magnus-berg/waxstation/src/waxstation.py

"""
WAXstation - control software for a chain waxing machine
Copyright (C) 2021  Magnus Berg 

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
from machine import Pin
from settings import Settings
from display import Display
import time
from time import sleep_ms as sleep
import time
from thermometer import Thermometer
from views import OffView, FixedTempView, AutoView
from settingsview import SettingsView

# WaxStation has 4 states
# 0 - Off
# 1 - Low temp
# 2 - High temp
# 3 - Auto temp
# 4 - Settings
class WaxStation:
    def __init__(self, pins, thermometer):
        self.settings = Settings()
        self.settings.load()
        self.waxtimer = None
        self.state = -1
        self.pins = pins
        self.offPin = pins['offPin']
        self.loPin = pins['loPin']
        self.hiPin = pins['hiPin']
        self.autoPin = pins['autoPin']
        self.sdaPin = pins['sdaPin']
        self.sclPin = pins['sclPin']
        self.relayPin = pins['relayPin']
        self.input = Input([self.autoPin, self.hiPin, self.loPin, self.offPin])
        self.display = Display(self.sdaPin, self.sclPin)
        self.view = OffView(self)
        self.thermometer = thermometer
        self.power = 0
        self.thermometer.settings = self.settings
        self.__powerTime = time.ticks_ms()
        self.powerled = Pin(25, Pin.OUT)

    def updatePower(self):
        timePassed = int((time.ticks_ms() - self.__powerTime)/1000)
        pm = self.settings.currentPowerMode()
        if  timePassed > (pm[1] + pm[2]):
            self.__powerTime = time.ticks_ms()
        elif timePassed > pm[1]:
            self.relayPin.value(0)
            self.powerled.value(0)
        else:
            self.relayPin.value(self.power)
            self.powerled.value(self.power)
            
    def run(self):
        while True:
            self.thermometer.read()
            
            if self.thermometer.temperature != -127 and self.thermometer.calibratedTemp() < self.goalTemp():
                self.power = 1
            elif self.thermometer.temperature == -127 or self.thermometer.calibratedTemp() >= self.goalTemp():
                self.power = 0
    
            self.updatePower()
            self.relayPin.value(self.power)
            
            buttons = self.input.update()
            newState = self.view.update(buttons)
            if newState != None and newState != self.state:
                self.state = newState
                self.display.poweron()
                if self.state == 0:
                    self.view = OffView(self)
                    self.view.update(buttons)
                    self.relayPin.value(0)
                    sleep(1000)
                    self.display.poweroff()
                elif self.state == 1 or self.state == 2:
                    self.view = FixedTempView(self)
                elif self.state == 3:
                    self.view = AutoView(self)
                elif self.state == 4:
                    self.view = SettingsView(self)


                        
            
    def goalTemp(self):
        if self.state == 1:
            return self.settings.lo.value
        elif self.state == 2: 
            return self.settings.hi.value
        elif self.state == 3: ## ???
            return self.settings.hi.value
        else:
            return 0

        

    
class Input:
    def __init__(self, pins):
        self.pins = pins
        self.state = [0] *len(self.pins)
        self.returnValue = [0] *len(self.pins)

    def update(self):
        for index, pin in enumerate(self.pins):
            pinValue = 1 if pin.value() == 0 else 0
            if pinValue == 1:
                self.returnValue[index] += 1
            else:
                self.returnValue[index] = 0
            self.state[index] = pinValue
            
        return self.returnValue        
