magnus-berg/waxstation/src/image.py

import framebuf

class Image:
    def __init__(self):
       
        self.image = {
            'logo': {
                'data': [
                0x80, 0x80, 0x00, 0x00, 0x00, 0x00, 0x00, 0x00, 0x00, 0x00, 0x00, 0x00, 0x00, 0x00, 0x00, 0x80, 
                0x80, 0x80, 0x80, 0x80, 0x00, 0x00, 0x00, 0x80, 0xc0, 0xe0, 0xf0, 0xf8, 0xf8, 0xfc, 0xfc, 0xfc, 
                0xfe, 0xfe, 0xfe, 0xfe, 0xfe, 0xfe, 0xfe, 0xfe, 0xfe, 0xfc, 0xfc, 0xfc, 0xf8, 0xf8, 0xf0, 0xf0, 
                0xe0, 0xe0, 0xc0, 0xc0, 0xc0, 0x80, 0x80, 0x80, 0x80, 0x00, 0x00, 0x00, 0x00, 0x00, 0x00, 0x00, 
                0x00, 0x00, 0x00, 0x00, 0x00, 0x00, 0x00, 0x80, 0x80, 0x80, 0x80, 0xc0, 0xc0, 0xc0, 0xe0, 0xe0, 
                0xe0, 0xf0, 0xf0, 0xf8, 0xf8, 0xfc, 0xfc, 0xfe, 0xfe, 0xfe, 0xfe, 0xfe, 0xfe, 0xfe, 0xfe, 0xfe, 
                0xfe, 0xfc, 0xfc, 0xf8, 0xf8, 0xf0, 0xe0, 0xe0, 0xc0, 0x80, 0x00, 0x00, 0x80, 0x80, 0x80, 0x80, 
                0x80, 0x00, 0x00, 0x00, 0x00, 0x00, 0x00, 0x00, 0x00, 0x00, 0x00, 0x00, 0x00, 0x00, 0x80, 0x80, 
                0xff, 0xff, 0xff, 0xff, 0xff, 0xff, 0xff, 0xff, 0xff, 0xff, 0xff, 0xff, 0xff, 0xff, 0xff, 0xff, 
                0xff, 0x1f, 0x03, 0xc0, 0xf8, 0xfe, 0xff, 0xff, 0xff, 0xff, 0xff, 0xff, 0xff, 0x7f, 0x3f, 0x1f, 
                0x0f, 0x0f, 0x07, 0x07, 0x07, 0x07, 0x07, 0x0f, 0x0f, 0x1f, 0x3f, 0xff, 0xff, 0xff, 0xff, 0xff, 
                0xff, 0xff, 0xff, 0xff, 0xff, 0xff, 0xff, 0xff, 0xff, 0xff, 0xff, 0xff, 0xff, 0xff, 0xff, 0xff, 
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
        }
 
    def getImage(self, name):
        img = self.image[name]
        buffer = bytearray(len(img['data']))
        for idx, byte in enumerate(img['data']):
            buffer[idx] = byte
        return framebuf.FrameBuffer(buffer, img['width'], img['height'], framebuf.MVLSB)
