magnus-berg/waxstation/(notices)

Notices in the files:
src/views.py:
it under the terms of the GNU General Public License as published by
